nordic-institute/harmony-smp/README.md

# Harmony eDelivery Access - Service Metadata Publisher (SMP)

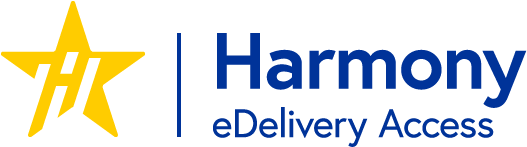
[picture p1: harmony-logo.png]
Harmony eDelivery Access logo


## About the Repository

This repository contains the source code of the SMP component of Harmony eDelivery Access. 

Harmony eDelivery Access by [NIIS](https://niis.org) is a free and actively maintained open-source component for joining one or more eDelivery policy domains.

Harmony SMP is based on upon the [SMP](https://ec.europa.eu/digital-building-blocks/code/projects/EDELIVERY/repos/smp) open source project by the [European Commission](https://ec.europa.eu/). 

## Documentation

The official Harmony documentation is available in a separate repository that can be found [here](https://github.com/nordic-institute/harmony-common/).

In addition, the following documents that are available on the [SMP release page](https://ec.europa.eu/digital-building-blocks/sites/display/DIGITAL/DomiSMP) are applicable for the Harmony SMP too:

 * Administration Guide 
 * Interface Control Documents
 * Software Architecture Document.

## Build

Harmony SMP can be built using the following command:

    ./mvnw clean install

Unit and integration tests can be skipped using the `skipTests` and `skipITs` properties:

    ./mvnw clean install -DskipTests -DskipITs

Full build instruction are available in the `harmony-common` [repository](https://github.com/nordic-institute/harmony-common/).

## Install and Run

Instructions to install and run Harmony SMP are available in the `harmony-common` [repository](https://github.com/nordic-institute/harmony-common/).
