nordic-institute/harmony-smp/domismp-tests/domismp-docker/images/oracle/README.md

Folder contains oracle images needed to build database and weblogic from 
[Oracle docker git](https://github.com/oracle/docker-images/).
 
In order to build those images following files must be downloaded from Oracle page
  - OracleDB 11xe: oracle-xe-11.2.0-1.0.x86_64.rpm.zip or   - OracleDB 19c: LINUX.X64_193000_db_home.zip
  - Server JDK 1.8:  server-jre-8u211-linux-x64.tar.gz  (https://github.com/oracle/docker-images/tree/master/OracleJava)
  - weblogic 12.2.1.4: fmw_12.2.1.4.0_wls_quick_Disk1_1of1.zip

For building docer images check readme files on [Oracle docker git](https://github.com/oracle/docker-images/).
