nordic-institute/harmony-smp/smp-server-library/ignoredIntegrationTests.txt

# integration tests in this file are ignored in harmony-pom.xml
