nordic-institute/harmony-smp/smp-server-library/ignoredTests.txt

# tests in this file are ignored in harmony-pom.xml
