nordic-institute/harmony-smp/smp-webapp/ignoredTests.txt

# tests in this file are ignored in harmony-pom.xml

# intermittent errors, do not happen when tests are run separately
ServiceGroupControllerTest
ApplicationResourceIntegrationTest
TruststoreAdminResourceIntegrationTest
UserAdminResourceIntegrationTest
