nordic-institute/harmony-smp/smp-server-library/src/main/java/eu/europa/ec/edelivery/smp/services/resource/AbstractResourceHandler.java

/*-
 * #START_LICENSE#
 * smp-server-library
 * %%
 * Copyright (C) 2017 - 2024 European Commission | eDelivery | DomiSMP
 * %%
 * Licensed under the EUPL, Version 1.2 or – as soon they will be approved by the European Commission - subsequent
 * versions of the EUPL (the "Licence");
 * You may not use this work except in compliance with the Licence.
 * You may obtain a copy of the Licence at:
 *
 * [PROJECT_HOME]\license\eupl-1.2\license.txt or https://joinup.ec.europa.eu/collection/eupl/eupl-text-eupl-12
 *
 * Unless required by applicable law or agreed to in writing, software distributed under the Licence is
 * distributed on an "AS IS" basis, WITHOUT WARRANTIES OR CONDITIONS OF ANY KIND, either express or implied.
 * See the Licence for the specific language governing permissions and limitations under the Licence.
 * #END_LICENSE#
 */
package eu.europa.ec.edelivery.smp.services.resource;

import eu.europa.ec.edelivery.smp.data.model.DBDomain;
import eu.europa.ec.edelivery.smp.data.model.doc.DBResource;
import eu.europa.ec.edelivery.smp.data.model.doc.DBSubresource;
import eu.europa.ec.edelivery.smp.data.model.ext.DBResourceDef;
import eu.europa.ec.edelivery.smp.data.model.ext.DBSubresourceDef;
import eu.europa.ec.edelivery.smp.exceptions.ErrorCode;
import eu.europa.ec.edelivery.smp.exceptions.SMPRuntimeException;
import eu.europa.ec.edelivery.smp.logging.SMPLogger;
import eu.europa.ec.edelivery.smp.logging.SMPLoggerFactory;
import eu.europa.ec.edelivery.smp.services.spi.SPIUtils;
import eu.europa.ec.edelivery.smp.services.spi.data.SpiRequestData;
import eu.europa.ec.edelivery.smp.servlet.ResourceResponse;
import eu.europa.ec.edelivery.smp.utils.StringNamedSubstitutor;
import eu.europa.ec.smp.spi.api.model.RequestData;
import eu.europa.ec.smp.spi.api.model.ResponseData;
import eu.europa.ec.smp.spi.exceptions.ResourceException;
import eu.europa.ec.smp.spi.resource.ResourceDefinitionSpi;
import eu.europa.ec.smp.spi.resource.ResourceHandlerSpi;
import eu.europa.ec.smp.spi.resource.SubresourceDefinitionSpi;
import org.apache.commons.lang3.StringUtils;

import java.io.ByteArrayInputStream;
import java.io.ByteArrayOutputStream;
import java.io.IOException;
import java.io.InputStream;
import java.util.List;
import java.util.Map;
import java.util.Optional;
import java.util.stream.Collectors;

public class AbstractResourceHandler {
    protected static final SMPLogger LOG = SMPLoggerFactory.getLogger(AbstractResourceHandler.class);
    private static final String EXPECTED_RESOURCE_CHARSET= "UTF-8";
    // the Spring beans for the resource definitions
    final List<ResourceDefinitionSpi> resourceDefinitionSpiList;
    final ResourceStorage resourceStorage;

    protected AbstractResourceHandler(List<ResourceDefinitionSpi> resourceDefinitionSpiList, ResourceStorage resourceStorage) {
        this.resourceDefinitionSpiList = resourceDefinitionSpiList;
        this.resourceStorage = resourceStorage;
    }

    public ResourceDefinitionSpi getResourceDefinition(DBResourceDef resourceDef) {
        LOG.debug("Get resource definition for the [{}]", resourceDef);
        Optional<ResourceDefinitionSpi> definitionSpi = resourceDefinitionSpiList.stream()
                .filter(rdspi -> StringUtils.equals(resourceDef.getIdentifier(), rdspi.identifier()))
                .findFirst();

        return definitionSpi.orElseThrow(() -> new SMPRuntimeException(ErrorCode.INTERNAL_ERROR,
                resourceDef.getIdentifier(),
                "Can not find resource definition for identifier: [" + resourceDef.getIdentifier() + "] Registered resource SPI IDs ["
                        + resourceDefinitionSpiList.stream()
                        .map(ResourceDefinitionSpi::identifier)
                        .collect(Collectors.joining(","))
                        + "]"));
    }

    public ResourceHandlerSpi getResourceHandler(DBResourceDef resourceDef) {
        LOG.debug("Get resource handler for the [{}]", resourceDef);
        return getResourceDefinition(resourceDef).getResourceHandler();
    }

    public SubresourceDefinitionSpi getSubresourceDefinition(DBSubresourceDef subresourceDef, DBResourceDef resourceDef) {
        LOG.debug("Get resource definition for the [{}] for resource [{}]", subresourceDef, resourceDef);
        ResourceDefinitionSpi resourceDefinitionSpi = getResourceDefinition(resourceDef);
        String subResourceId = subresourceDef.getIdentifier();
        // get subresource implementation by identifier
        Optional<SubresourceDefinitionSpi> optSubresourceDefinitionSpi = resourceDefinitionSpi.getSubresourceSpiList().stream()
                .filter(def -> StringUtils.equals(def.identifier(), subResourceId)).findFirst();

        return optSubresourceDefinitionSpi.orElseThrow(
                () -> new SMPRuntimeException(ErrorCode.INTERNAL_ERROR, subResourceId,
                        "Can not find subresource definition: [" + subResourceId + "]. Registered subresource IDs ["
                                + resourceDefinitionSpi.getSubresourceSpiList().stream()
                                .map(SubresourceDefinitionSpi::identifier)
                                .collect(Collectors.joining(","))
                                + "]"));
    }

    public ResourceHandlerSpi getSubresourceHandler(DBSubresourceDef subresourceDef, DBResourceDef resourceDef) {
        LOG.debug("Get resource handler for the [{}]", subresourceDef);
        return getSubresourceDefinition(subresourceDef, resourceDef).getResourceHandler();
    }

    /**
     * Build handler RequestData and add resource from the database
     *
     * @param domain   for the resource
     * @param resource an entity
     * @return data handler request data
     */
    public RequestData buildRequestDataForResource(DBDomain domain, DBResource resource) {

        byte[] content = resourceStorage.getDocumentContentForResource(resource);
        if (content == null || content.length == 0) {
            throw new SMPRuntimeException(ErrorCode.RESOURCE_DOCUMENT_MISSING, resource.getIdentifierValue(), resource.getIdentifierScheme());
        }
        return buildRequestDataForResource(domain, resource, new ByteArrayInputStream(content));
    }

    public RequestData buildRequestDataForResource(DBDomain domain, DBResource resource, InputStream inputStream) {
        Map<String, String> docProp = resourceStorage.getResourceProperties(resource);
        try (ByteArrayOutputStream baos = new ByteArrayOutputStream()) {
            if (inputStream != null && inputStream.available() != 0) {
                StringNamedSubstitutor.resolve(inputStream, docProp, baos, EXPECTED_RESOURCE_CHARSET);
            }
            return new SpiRequestData(domain.getDomainCode(),
                    SPIUtils.toUrlIdentifier(resource),
                    new ByteArrayInputStream(baos.toByteArray()));
        } catch (IOException e) {
            throw new SMPRuntimeException(ErrorCode.RESOURCE_DOCUMENT_MISSING, resource.getIdentifierValue(), resource.getIdentifierScheme());
        }
    }

    /**
     * Build handler RequestData and add resource from the database for the subresource
     * It reads the content of the subresource from the database and replaces the properties in the document.
     * @param domain
     * @param resource
     * @param subresource
     * @return
     */
    public RequestData buildRequestDataForSubResource(DBDomain domain, DBResource resource,
                                                      DBSubresource subresource) {
        byte[] content = resourceStorage.getDocumentContentForSubresource(subresource);
        if (content == null || content.length == 0) {
            throw new SMPRuntimeException(ErrorCode.SUBRESOURCE_DOCUMENT_MISSING,
                    subresource.getIdentifierValue(), subresource.getIdentifierScheme(),
                    resource.getIdentifierValue(), resource.getIdentifierScheme());
        }
        return buildRequestDataForSubResource(domain, resource, subresource, new ByteArrayInputStream(content));
    }

    /**
     * Build handler RequestData and add resource from the database. The input stream is used to replace the properties
     * in the document and the new bytearrays is used as stream  to create the RequestData.
     * @param domain of the resource
     * @param resource the parent resource of the subresource
     * @param subresource an entity with the subresource data
     * @param inputStream the input stream to replace the properties in the document
     * @return request data for the subresource
     */
    public RequestData buildRequestDataForSubResource(DBDomain domain, DBResource resource, DBSubresource subresource, InputStream inputStream) {
        Map<String, String> docProp = resourceStorage.getSubresourceProperties(resource, subresource);
        try (ByteArrayOutputStream baos = new ByteArrayOutputStream()) {
            if (inputStream != null && inputStream.available() != 0) {
                StringNamedSubstitutor.resolve(inputStream, docProp, baos, EXPECTED_RESOURCE_CHARSET);
            }
            return new SpiRequestData(domain.getDomainCode(),
                    SPIUtils.toUrlIdentifier(resource),
                    SPIUtils.toUrlIdentifier(subresource),
                    new ByteArrayInputStream(baos.toByteArray()));
        } catch (IOException e) {
            throw new SMPRuntimeException(ErrorCode.RESOURCE_DOCUMENT_MISSING, resource.getIdentifierValue(), resource.getIdentifierScheme());
        }
    }

    public void handleReadResource(ResourceHandlerSpi handlerSpi, RequestData requestData, ResponseData responseData, ResourceResponse resourceResponse) {
        try {
            handlerSpi.readResource(requestData, responseData);
            if (StringUtils.isNotBlank(responseData.getContentType())) {
                resourceResponse.setContentType(responseData.getContentType());
            }
            responseData.getHttpHeaders().forEach(resourceResponse::setHttpHeader);

        } catch (ResourceException e) {
            throw new SMPRuntimeException(ErrorCode.INTERNAL_ERROR, "Error occurred while reading the subresource!", e);
        }
    }
}
