nordic-institute/harmony-smp/(commit log)

2012-07-18 Peppol sample implemenation of the access point (from peppol joinup project)
2013-03-28 Removed these 2 projects, as they are moved to phloc-schematron at http://code.google.com/p/phloc-schematron/
    [BII03_en.sch, BII06_en.sch, Order-core_en.sch, OrderResponseSimple-core_en.sch]
2013-04-15 Fixed SPI filename
2013-04-15 Updated to most current version
2013-04-15 Updated generated rules - replaced "//" with "/" in XPath expression, because this made problems with "ID" below "TaxCategory"
    [ATGOV-T10-abstract.sch, ATGOV-UBL-T10-test.sch, ATGOV-UBL-T10.sch, ATNAT-T10-abstract.sch, ATNAT-UBL-T10-test.sch, ATNAT-UBL-T10.sch, BIICORE-T01-abstract.sch, BIICORE-T10-abstract.sch]
2013-05-02 Updated to phloc-db instead of commons-jpa for a thread-safe JPA handling.
2013-05-05 Fixed naming of directories
    [ATGOV-T10-abstract.sch, ATGOV-UBL-T10-test.sch, ATGOV-UBL-T10.sch, ATNAT-T10-abstract.sch, ATNAT-UBL-T10-test.sch, ATNAT-UBL-T10.sch, BIICORE-T01-abstract.sch, BIICORE-T10-abstract.sch]
2013-05-07 Handling exceptions in case of invalid XML in extensions - EDELIVERY-104
2013-05-24 Renamed an SPI interface and all implementations
2013-07-16 Removed ATGIV rules 2, 6 and 8 as they are no longer needed!
    [ATGOV-T10-abstract.sch, ATGOV-UBL-T10-test.sch, atgov-T10-BusinessRules-v01.ods]
2013-07-16 Fixed naming
    [NOGOV-UBL-T10-test.sch, NOGOV-UBL-T14-test.sch, NOGOV-UBL-T15-test.sch]
2013-07-16 Renamed files
    [NONAT-UBL-T17-test.sch, NONAT-UBL-T17.sch]
2013-07-16 Fixed invalid tab name
    [nonat-T17-BusinessRules-v01.ods]
2013-07-18 Added new identifier issuing agency NL:KVK
    [PEPPOL Code Lists 1.1.2.xls]
2013-08-14 Added new Identifier Issuing Agency NL:ION (9954)
    [PEPPOL Code Lists 1.1.3.xls]
2013-09-03 Using RM timeout setting of 1 millisecond as a close will never be retrieved.
2013-09-03 Fixed some warnings because of unhandled switch cases
2013-10-21 Added a new Austrian rule ON VAT
    [ATNAT-T10-abstract.sch, ATNAT-UBL-T10-test.sch, NONAT-T17-abstract.sch, NONAT-UBL-T17-test.sch, atnat-T10-BusinessRules-v01.ods]
2013-11-15 Fixed problem with multiline certificate printing and signature validation
2013-11-15 Updated to current smp-server-library
2013-11-15 Printing hex serial number
2013-11-29 Test framework updates for Nov-13 release
    [e-Delivery - AP.xls, e-Delivery - AS2 AP.xls, e-Delivery - SML.xls, e-Delivery - SMP.xls, e-Delivery - START AP.xls]
2014-01-07 Updated PEPPOL codelist to 1.1.4 by changing NL:ION to NL:OIN as requested by Sven
    [PEPPOL Code Lists 1.1.4.xls]
2014-01-30 Updated Test Cases after receiving the final AS2 specifications
    [e-Delivery - AS2 AP.xls]
2014-04-30 Updated test cases after checking released specifications, interoperability test plan and ad-hoc testing
    [e-Delivery - AS2 AP.xls, e-Delivery - SMP.xls]
2014-05-28 Update for CIPA e-Delivery v2.1.0
    [e-Delivery - AS2 AP.xls, e-Delivery - SML.xls, e-Delivery - SMP.xls, e-Delivery - START AP.xls]
2014-06-06 Updated create rules with less XML quoting
    [ATGOV-UBL-T10-test.sch, ATNAT-UBL-T10-test.sch, BIICORE-T01-abstract.sch, BIICORE-T10-abstract.sch, BIICORE-T15-abstract.sch, BIICORE-UBL-T01-test.sch, BIICORE-UBL-T10-test.sch, BIICORE-UBL-T14-test.sch]
2014-06-10 fixed: now SendWebservice returns an error in case one of the mandatory fields in the SBDH document are missing
2014-06-10 fix: now AS2ReceiverServlet returns and error in case as2-from is not the same as the signing certificate's CN
2014-06-27 https://webgate.ec.europa.eu/CITnet/jira/browse/EDELIVERY-261?filter=-1
    commit for EDELIVERY-261 jira task
2014-07-10 removed mysql-connector from dependencies, added weblogic.xml for deployment on weblogic
2014-07-10 remove mysql-connectore depenency
2014-09-11 Deprecated some constants that contain the current SML URLs in a constant way
2014-09-23 chenged scope filters
2014-10-03 Started adding predefined OpenPEPPOL process and document type identifiers
    [PEPPOL Code Lists 1.1.5.xls]
2014-10-03 Added more codelist items and changed version to 1.2.0
    [PEPPOL Code Lists 1.1.5.xls, PEPPOL Code Lists 1.2.0.xls]
2014-10-03 Added identifiers
    [PEPPOL Code Lists 1.2.0.xls]
2014-10-07 Moved Oxalis connector to discontinued
2014-10-13 Added latest OpenPEPPOL rule set
    [BIICORE-UBL-T01-V1.0.sch, BIICORE-UBL-T10-V1.0.sch, BIICORE-UBL-T14-V1.0.sch, BIICORE-UBL-T16-V1.0.sch, BIICORE-UBL-T19-V1.0.sch, BIIRULES-T01.sch, BIIRULES-T10.sch, BIIRULES-T14.sch]
2014-10-20 Switched from SSL to TLS
2014-11-03 Updated to V2
    [atnat-T10-BusinessRules-v01.ods, atnat-T10-BusinessRules-v02.ods]
2014-11-03 Updated AT business rules
    [atgov-T10-BusinessRules-v01.ods, atgov-T10-BusinessRules-v02.ods, atnat-T10-BusinessRules-v02.ods]
2014-11-03 Updated generated rules slightly
    [ATGOV-T10-abstract.sch, ATGOV-UBL-T10-test.sch, ATGOV-UBL-T10.sch, ATNAT-T10-abstract.sch, ATNAT-UBL-T10-test.sch, ATNAT-UBL-T10.sch, BIICORE-T01-abstract.sch, BIICORE-T10-abstract.sch]
2014-11-04 sendind the whole sbdh message instead of the payload. Changed return message in case of success send
2014-11-04 Improved AT rules
    [ATGOV-UBL-T10-test.sch, ATNAT-T10-abstract.sch, ATNAT-UBL-T10-test.sch, atgov-T10-BusinessRules-v02.ods, atnat-T10-BusinessRules-v02.ods]
2014-11-05 Extracted prerequisites into global variables for increased readability
    [ATGOV-UBL-T10-test.sch, ATGOV-UBL-T10.sch, ATNAT-UBL-T10-test.sch, ATNAT-UBL-T10.sch, BIICORE-UBL-T01-test.sch, BIICORE-UBL-T01.sch, BIICORE-UBL-T10-test.sch, BIICORE-UBL-T10.sch]
2014-11-05 Added AT T14 rules
    [atgov-T10-BusinessRules-v02.ods, atgov-T14-BusinessRules-v02.ods, atnat-T10-BusinessRules-v02.ods, atnat-T14-BusinessRules-v02.ods]
2014-11-05 Added AT T14 Schematrons & XSLT
    [ATGOV-T10-abstract.sch, ATGOV-T14-abstract.sch, ATGOV-UBL-T10-test.sch, ATGOV-UBL-T14-test.sch, ATGOV-UBL-T14.sch, ATNAT-T10-abstract.sch, ATNAT-T14-abstract.sch, ATNAT-UBL-T10-test.sch]
2014-11-25 RESOLVED - issue EDELIVERY-289: Incorrect handling of upper/lower case in PrepareToMigrate service https://webgate.ec.europa.eu/CITnet/jira/browse/EDELIVERY-289
2014-11-25 Updated ATGOV rules
    [ATGOV-T10-abstract.sch, ATGOV-T14-abstract.sch, ATGOV-UBL-T10-test.sch, ATGOV-UBL-T14-test.sch, atgov-T10-BusinessRules-v02.ods, atgov-T10-BusinessRules-v03.ods, atgov-T14-BusinessRules-v02.ods, atgov-T14-BusinessRules-v03.ods]
2014-11-25 Added further test case files
2014-11-26 Fixed T14 AT rules
    [ATGOV-UBL-T14.sch, ATNAT-UBL-T14.sch, atgov-T14-BusinessRules-v03.ods, atnat-T14-BusinessRules-v02.ods]
2014-11-26 format change
    [atnat-T10-BusinessRules-v02.ods, atnat-T14-BusinessRules-v02.ods]
2014-11-26 Tried to speed up processing
    [ATGOV-UBL-T10-test.sch, ATGOV-UBL-T14-test.sch, atgov-T10-BusinessRules-v03.ods, atgov-T14-BusinessRules-v03.ods]
2014-12-05 Enable SOAP UI automated tests for SMP (they fail currently and need to be fixed)
2015-01-29 Removed the dependency to Spring because it was only used in a deprecated class, which has now been removed
2015-01-30 Update powermock to 1.6.1 in order to avoid a compatibility problem between the 1.6.0 version and the new JUnit 4.12 version
2015-02-10 Switch address from 192.168.10.11 to 192.168.56.11 because 192.168.56.* is the default network for the virtual boxes
2015-02-13 Added test case for rule ATNAT-T10-R007
2015-02-13 Added new rules: ATNAT-T10-R007 and ATNAT-T14-R007
    [ATNAT-T10-abstract.sch, ATNAT-T14-abstract.sch, ATNAT-UBL-T10-test.sch, ATNAT-UBL-T14-test.sch, atnat-T10-BusinessRules-v03.ods, atnat-T10-BusinessRules-v04.ods, atnat-T14-BusinessRules-v03.ods, atnat-T14-BusinessRules-v04.ods]
2015-03-11 fix extra space in jdbc.url and jdbc.driver
2015-03-19 Updated test cases after February test run
    [e-Delivery - AS2 AP.xls, e-Delivery - SML.xls, e-Delivery - SMP.xls, e-Delivery - START AP.xls]
2015-04-08 Added SE:VAT and ZZZ
    [PEPPOL Code Lists 1.2.1.xls]
2015-04-17 add default pmodes and fix issue https://issues.jboss.org/browse/JBPAPP-9393 with solution found there : https://developer.jboss.org/thread/201170
2015-04-22 Correct the context path from etrustex to connector and added xnio module dependencies for domibus (required for remoting)
2015-04-28 If we don't comment the following line, the a warning is displayed because of the use of Spring @Transactional with propagation REQUIRES_NEW in LogService. A quick fix to make it disappear is to disa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
2015-08-21 Added pmode configuration files and switch from sender/receiver to local/VM
2015-08-21 fix assembly with new location of the domibus war
2015-10-16 Switched to domibus 3
2015-10-16 Switched back to domibus 2 while waiting for the resolution of a problem with Joinup
2015-10-21 Switching to 3.0.0 (to prepare the tag)
2015-10-21 eDelivery 3.0.0 inluding: Domibus 3.0 BDMSL
    [e-Delivery - AS2 AP.xls, e-Delivery - SML.xls, e-Delivery - SMP.xls]
2015-10-21 eDelivery 3.0.0 including: Domibus 3.0 BDMSL 3.0
    [PEPPOL Code Lists 1.0.0.xls, PEPPOL Code Lists 1.0.1.xls, PEPPOL Code Lists 1.0.2.xls, PEPPOL Code Lists 1.1.0.xls, PEPPOL Code Lists 1.1.1.xls, PEPPOL Code Lists 1.1.2.xls, PEPPOL Code Lists 1.1.3.xls, PEPPOL Code Lists 1.1.4.xls]
2015-10-21 Switched version to 3.1.0-SNAPSHOT
2015-11-05 Integration of the fixes of the version 3.0.1: EDELIVERY-526: The hashing of DNS records must be case insensitive EDELIVERY-527: Force the Locale of the hashing to make it EDELIVERY-530: Wrong regula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
2015-11-05 switch to 3.2.0-SNAPSHOT after tag 3.1.0
2015-12-11 Added attachements
2015-12-16 Add domibus-app to the joinup svn
    [domibus-app-log4j.xml]
2015-12-17 Update assembly for Release Notes 3.2.0
2016-09-16 Attaching lib dependencies into the project
2017-01-11 EDELIVERY-1699 - switched to the new OASIS API - code compiles - tests still not compiles
2017-01-27 EDELIVERY-1773 Added dirty but looking like working Spring Security configuration for Basic Auth
2017-01-27 EDELIVERY-1773 Glued Spring-Security AuthenticationException thrown from Basic Auth to be handled by our current Jersey-exception-mappers
2017-02-09 EDELIVERY-1726 - Removed legacy and garbage modules :)
    [ATGOV-T10-abstract.sch, ATGOV-T14-abstract.sch, ATGOV-UBL-T10-test.sch, ATGOV-UBL-T10.sch, ATGOV-UBL-T14-test.sch, ATGOV-UBL-T14.sch, ATNAT-T10-abstract.sch, ATNAT-T14-abstract.sch]
2017-02-10 EDELIVERY-1726 - Removed no longer valid SoapUI tests (API was modified in a meanwhile)
    [e-Delivery - AS2 AP.xls, e-Delivery - SML.xls, e-Delivery - SMP.xls]
2017-02-27 EDELIVERY-1834 Case sensitivity issue fix for Identifiers - dirty code
2017-03-16 EDELIVERY-1834 changed sample configuration file
2017-03-27 EDELIVERY-1835 Fixed case-sensitivity issue in returned ServiceGroup references
2017-04-07 EDELIVERY-1977 Implemented BlueCoat authentication with Spring Security
2017-04-10 EDELIVERY-1977 Added configurable switch ON/OFF for Blue Coat authentication
2017-04-21 EDELIVERY-2112 Oracle OJDBC driver needed for integration tests is downloaded from repo only if flag -DskipTests is not set to true
2017-04-21 EDELIVERY-1977 debug level for spring security logging - investigating issues on DEV
2017-04-21 EDELIVERY-1977 reverted debug level for spring security logging - investigating issues on DEV
2017-04-24 EDELIVERY-2112 Added missing oracle driver version for soapUI tests
2017-04-25 EDELIVERY-1952 SpringSecurity - enabled X509 Certificate authentication
2017-07-03 EDELIVERY-2257 Added code coverage plugin and configured for eDelivery Sonar server
2017-08-25 EDELIVERY-2525 Forced SML integration to use original SUN Java WS client instead of CXF - there was problem in configuring client certificate with the Java-code approach used in current implementatio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
2017-11-08 EDELIVERY-2258 Refactored REST layer, migrated to Spring MVC, applied few other refactorings
2017-12-22 EDELIVERY-1978 Upgraded Java from 7 to 8. Upgraded Spring from 4 to 5.0.2. Removed SML registration hook filter.
2018-01-04 EDELIVERY-1978 Fixed WebLogic issue with spring-web.jar
2018-02-02 EDELIVERY-2530 Upgraded JDBC driver versions for Oracle and MySQL
2018-02-05 [EDELIVERY-3114] upgraded sonar maven plugin
2018-02-05 [EDELIVERY-3114] downgraded sonar maven plugin
2018-02-05 [EDELIVERY-3114] downgraded sonar maven plugin + refactoring
2018-02-05 [EDELIVERY-3114] downgraded sonar maven plugin again
2018-02-06 [EDELIVERY-3114] try to increase versions pfr maven and sonar plugin
2018-02-13 EDELIVERY-2260 Created sample configuration ZIP distribution
2018-02-15 EDELIVERY-2307 Added sample SoapUI project
2018-02-16 EDELIVERY-2307 Fixed few comments in sample SoapUI project
2018-02-22 EDELIVERY-3164 Improved Domain ID validation and decreased spring logging level
2018-02-28 EDELIVERY-3185 Fixed Partcipant case-sensitivity configuration glitch
2018-05-17 Disable .Net Assembly Analyzer for dependency-check.
2018-06-11 OWASP Upgrade spring.version from 5.0.2.RELEASE to 5.0.6.RELEASE spring.security.version from 4.2.1.RELEASE to 4.2.6.RELEASE
2018-08-30 update sonar warnings
2018-08-31 exclude ts from sonar
2018-08-31 exclude entity classes from sonar code coverage
2018-09-03 Wrap javax.xml.validation.Validator into ThreadLocal
2018-09-27 EDELIVERY-3762 Clean the smp-angular project from domibus object
    Rename files as per Angular guidelines.
    Remove message filter and error log components.
    Exclude the error log component.
    Disabl the page helper until we figure out if we need it.
2018-10-08 - Change pom version to 4.1.0-SNAPSHOT - update database model - introduce surrogate keys - split certificate from user table - improve domain model - enable JPA 2.1 for database schema generation - 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
    [eu.europa.ec.cipa.smp.server.security.SecurityConfigurationTest.txt]
2018-10-08 -clean the target folders.
    [eu.europa.ec.cipa.smp.server.security.SecurityConfigurationTest.txt]
2018-10-12 EDELIVERY-3687 SMP UI Add/Edit user
    Upgrade Angular to 6.1.10 (i.e. latest): upgrade to the HttpClient.
    Upgrade Angular Material to 6.4.7 (i.e. latest): upgrade to mat-*
    elements, attributes and directives; fix date pickers; fix missing
    md-input-containers elements.
    Upgrade RxJS to 6.2.2 (i.e. latest). Remove RxJS from devDependencies.
    Remove unused codelyzer dependency.
    Remove no longer needed md2 dependency.
    Add section for the certificate to the user screen.
    Add certificate service to support uploading certificates to the server.
2018-10-15 set Edit Service group page for Edit - change expand button with (+), (-)
2018-10-18 EDELIVERY-3687 SMP UI Add/Edit user
    Rename validUntil to validTo as present in the back-end.
    Add support for fingerprints when reading the uploaded certificate.
    Add Jackson 2 support for JSR310 dates and configure a Jackson 2
    HttpMessageConverter.
2018-10-18 EDELIVERY-3687 SMP UI Add/Edit user
    Replace fingerprint with serial number.
2018-10-25 - bugfixes - update button for generating client cert header on domain - domain warnings on delete
2018-11-08 EDELIVERY-4054 Existing password is being accepted in change password
    Add user modes to distinguish between different types of operations
    (adding or editing users by the system administrators and users editing
    their own details).
    Rename the H2JPA test configuration files to follow the same naming
    convention.
    Add converters transforming between UserRO and DBUser objects.
    Fix issue with crt files being filtered by Maven preventing them being
    referenced relatively from the target folder.
2018-11-09 update library versions bdmsl-client:3.0.0 - bdmsl-api:3.1.3 jackson from 2.9.2 to 2.9.7 jaxb2-basics from 0.11.0 to 1.11.1 cxf from 3.2.1 to 3.2.7 remove JDBC drivers
2018-11-13 EDELIVERY-4054 Existing password is being accepted in change password
    Add support for loading users details by their primary keys.
    Ensure the previous password check happens against the data persisted
    in the data store and not against the principal as it may be out of
    sync.
    Repopulate the local storage after the currently logged in user's
    details change.
2018-11-16 EDELIVERY-4084 User is not redirected to login when saving a new user
    Correctly configure and use the ExtendedHttpClient inside the search
    table component.
    Refresh the browser in case of a logout to ensure the login component
    is displayed by the authentication guard (after a timeout or a manual
    logout).
2018-11-22 - fix sonar 'E' warning
2018-11-22 - fix c sonar warnings
2018-11-22 - fix 4 Vulnerabilities reported by sonar
2018-11-24 Update jaccoco,surefire and sonar plugin version
2018-11-26 - fix sonar warnigns
2018-11-29 Fix button label for keystore from cancel to close
2018-12-05 Update update for sonar B warnings
2018-12-06 sml connector test
2018-12-06 unit test for SML integration - fix for sonar
2018-12-06 Fix sonar coverage - some tests are not taken into-account in sonar
2018-12-06 sml tests sonar issue
2018-12-06 sonar code coverage issue
2018-12-06 sonar test
2018-12-06 sonar code coverage fix
2018-12-12 add maven parameter for url and driver location for SMP ui tests project
2018-12-14 Project small modifications. Added test SMP087-Basic Flow-Empty DocumentIdentifier Type Schema.
2019-08-14 case insensitive certificate id search
2019-09-06 Update property framework and add new unit tst
2019-09-07 Update property framework and add new unit tests2
2019-09-10 fix case normalizer for null scheme
2019-09-12 fix sonar warnings
2019-09-26 Sonar warning
2019-09-26 Clean teardown script in MP084-Create ServiceGroup-Basic Flow-Admin test
2019-10-09 Fix tooltip for validation XML and sonar warnings
2019-10-18 - fix issues sonar warning
2021-09-15 Set spring security programmatically and add session cookie parameters
2021-12-17 - fixed applicationid - moved licence link to bottom of button list
2022-01-31 1) handling of cookies from login method to other Rest Api Method - Fix of 401 Unauthorized 2) Handling nullpointer exception while quitting of driver in BaseTest class 3) Code Fix for SRCH-60 and SR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
2022-02-22 Upgrade angular version to 13 and fix button visibility issue
2022-04-15 sonar issue
2022-04-26 Fix edit button
2022-04-27 Fix UI: showing row action buttons and table details
2022-04-28 Upgrade spring
2022-05-03 Implement SPI framework with payload validation SPI
2022-05-12 1)Rest endpoint changes. 2)Login failed message changed. 3)User retriving process changed during create service. 4)Null pointer exception handled during driver closing. 5)Reduce the zoom efect during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
2022-05-25 Add maven deploy for spi + smp example
2022-05-31 deploy root, api and spi modules to nexus and update README.md
2022-06-08 change id of the info dialog close button
2022-06-08 fix table action buttons
2022-08-12 Disabled a test case in propertyPgTest
2023-01-18 add spring-boot startup module
2023-04-11 Fix readme description for docker and springboot
2023-04-12 Fix springboot properties
2023-04-12 Update user administration and add windows OS script for springboot
2023-04-19 fix oracle bamboo plan init stripts
    [ResourceHandlerService.java]
2023-04-19 fix springboot JAXB adapter issue (with the new version of DDC)
2023-04-24 fix BDMSL integration configuration
    [ResourceHandlerService.java]
2023-04-28 fix sonar issues
2023-04-29 Fix UI participant identifier handling (case-sensitive, scheme mandatory, etc.. )
    [SmpIdentifierService.java]
2023-05-03 upgrade spring libraries
2023-05-23 upgrade springboot version
2023-05-25 Set spring transactions and add rollback and clean migration scripts
2023-06-02 Add ui button ids for testing
2023-06-05 Fix "public" search filter issue
2023-06-12 Add cppa3 spi implementation example
2023-07-16 Add resource extension SPI unit tests
2023-07-17 Add example resource extension SPI unit tests
2023-07-24 Added generic class with grid, buttons and pagination for pages like Users, Domains etc.
2023-08-04 fix sonar reported issue
2023-11-10 Fix button id
2023-11-16 Synchronize response error on empty payload
    [AbstractResourceHandler.java]
2023-11-20 Update spring annotation
2023-11-30 Add springboot image and integration test plan
2023-12-08 fix internal error on generating subresource via UI
    [AbstractResourceHandler.java, ResourceHandlerService.java]
2023-12-10 EDELIVERY-11674 Alerts - UI Improvements
    Show time to Alert date column in the Alerts table.
    Add Status Description data when displaying an Alert in a popup.
    Use title case for key labels when displaying an Alert in a popup.
    Update Alert popup title.
2023-12-20 [EDELIVERY-12110] fix UNAUTHORIZED http response from 400 to 401, implement legacy behaviour to add REST API create-resource requestor as default owner, and update soapui to mach thew new behaviour
    [ResourceHandlerService.java]
2024-01-04 [EDELIVERY-12658] update weblogic and springboot plans
2024-02-02 EDELIVERY-11315 Update Property Names and Description
    Update service group and service metadata names.
    Fix issue with the Oracle data script.
    [OasisSMPExtension.java, OasisSMPResource10.java, OasisSMPResource10Handler.java, OasisSMPResource20.java, OasisSMPResource20Handler.java, OasisSMPSubresource10.java, OasisSMPSubresource10Handler.java]
2024-02-07 [EDELIVERY-12625] Fix formatting on store Oasis SMP resource
    [OasisSMPResource10Handler.java, OasisSMPResource20Handler.java]
2024-02-28 [EDELIVERY-12899] remove juni4 and use only junit5 test framework
2024-03-01 EDELIVERY-11816 Resources Search Filter Does Not Support Colon Caracter
    Add annotation to decode URI-encoded filter values.
2024-03-18 [EDELIVERY-11518] add option Adotpion JDK 8 and JDK 11 to start tomcat and springboot images.
2024-03-25 EDELIVERY-11391 SMP - Trustore - System admin is able to import duplicated certificates
    Verify if certificates being uploaded already exist in the current keystore or truststore.
2024-03-29 EDELIVERY-12927 Resources Search Filter Treats % Character as Placeholder
    Escape SQL characters before wrapping with the final % LIKE characters.
2024-05-13 EDELIVERY-12848 Implement additional search filters in the search page
    Add extra filters for the domain code and the document type.
2024-05-13 EDELIVERY-12848 Implement additional search filters in the search page
    Add missing Angular resources.
2024-05-14 EDELIVERY-12848 Implement additional search filters in the search page
    [PR] Add button to clear filter.
    [PR] Use existing ResourceDef DAO to fetch and filter document types.
    [PR] Rename resource metadata.
2024-05-15 EDELIVERY-12848 Implement additional search filters in the search page
    [PR] Fix the height of the filter select fields.
2024-05-21 EDELIVERY-12848 Implement additional search filters in the search page
    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
2024-06-09 fix unit test build
    [AbstractHandler.java, OasisCppa3CppHandler.java, OasisSMPResource10Handler.java, OasisSMPResource20Handler.java, OasisSMPSubresource10Handler.java]
2024-06-10 EDELIVERY-12752 UI enhancement Users are warned before session expire
    [PR] Add icons to the action buttons.
2024-06-12 Fix sonar plans issues
2024-06-14 Fix bamboo plan - increase timeout and retries for springboot image health
2024-06-27 Fix invalid utf-8 character handling
    [AbstractResourceHandler.java]
2024-08-07 EDELIVERY-13528 Part-1 Runtime Translation Using ngx-translate
    Switch to async translations (resource search landing page missing translations issue).
    Update English translations.
2024-09-17 [URGENT] fix review flow blocking issues
2024-09-18 [URGENT] fix for template reference definiton
    [AbstractResourceHandler.java]
2024-09-19 [EDELIVERY-13793] Fix filter list to return only domains and resourceDef for which user has rights.
2024-09-19 [EDELIVERY-13956] UI: event table filter is not working
2024-09-19 Add replace toggle button with selection in the UI document editor
    [ResourceHandlerService.java]
2024-09-22 [EDELIVERY-13740, EDELIVERY-13738] fix UI domain-property dialog description and close button
2024-09-23 [EDELIVERY-13369] add scheme validation for the sample extension
2024-09-25 [EDELIVERY-12743] fix case sensitive case scheme changed to insensitive
2024-10-10 [EDELIVERY-14110] fix document property validation for non string types
    [AbstractResourceHandler.java, SMPExtensionInitializer.java]
2024-10-11 [EDELIVERY-140016] fix reset button dialog reference and change icon and label on main search page
2024-10-16 fix oasis smp 2.0 context path example
    [OasisSMPResource20.java]
2024-10-17 [EDELIVERY-14155] fix oasis smp 2.0 context path example
    [OasisSMPResource20.java]
2025-04-28 [EDELIVERY-14916] Synchronize L&F of landing html page with the DomiSML
